toandeptrai16zz/UAV_FAMER/Tài Liệu/MC6C_Tam_Cu_SBUS.pdf

UAV F450 | Lưu thông số điều khiển MC6C | Trang 1

# THÔNG SỐ TÂM TAY ĐIỀU KHIỂN CŨ

Microzone MC6C + bộ thu MC7RE | Số liệu SBUS đã xác nhận trước khi chỉnh nhầm trên tay điều khiển.
ROLL · CH1 | PITCH · CH2 | YAW · CH4
952 | 1062 | 1099

Bảng giá trị SBUS đã ghi nhận

Kênh | Chức năng | Giá trị đã xác nhận
CH1 | Roll (trái/phải) | Trung tâm: 952
CH2 | Pitch (lên/xuống) | Trung tâm: 1062
CH3 | Throttle / Ga | Thấp nhất: 40 · Cao nhất: 1640
CH4 | Yaw (xoay) | Trung tâm: 1099
CH5 | ARM | OFF: 1000 · ON: 1800
CH6 | KILL | ON (ngắt motor): 1800 · OFF: 1000

Các hằng số đang lưu trong rc_input.h

RC_ROLL_CENTER = 952 RC_PITCH_CENTER = 1062 RC_YAW_CENTER = 1099 RC_STICK_DEADBAND = 20 RC_THR_MIN_RAW = 40 RC_THR_MAX_RAW = 1640

Lưu ý khi đối chiếu với tay điều khiển hiện tại

Các số trên là giá trị cũ đã đo, không nhất thiết là giá trị mới sau khi bấm nhầm hoặc reset tay. Không ghi đè bằng tâm hiện tại nếu chưa kiểm tra trim, MIX và hướng điều khiển. Với bài kiểm tra an toàn, tháo cánh và ngắt nguồn ESC trước khi chỉnh tay.

Nguồn: các log SBUS trước khi thay đổi cài đặt tay và tệp rc_input.h của dự án STM32G474RE.
