toandeptrai16zz/UAV_FAMER/PINOUT.png

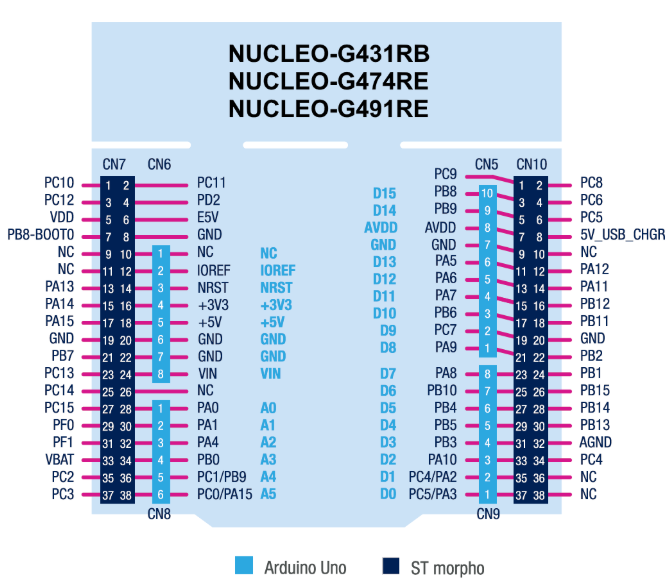
PINOUT.png
