toandeptrai16zz/UAV_FAMER/UAV_.ioc

Mcu.UserName=STM32G474RETx
PA13.Signal=SYS_JTMS-SWDIO
PA14.Signal=SYS_JTCK-SWCLK
PC1.Signal=LPUART1_TX
PC0.Signal=LPUART1_RX
PA7.Signal=S_TIM3_CH2
PA6.Signal=S_TIM3_CH1
PB0.Signal=S_TIM3_CH3
PB1.Signal=S_TIM3_CH4
PB12.GPIO_Label=IMU
PB12.Signal=GPIO_Output
PB13.Signal=SPI2_SCK
PB14.Signal=SPI2_MISO
PB15.Signal=SPI2_MOSI
PB7.Signal=USART1_RX
PB8-BOOT0.Signal=I2C1_SCL
PB9.Signal=I2C1_SDA
PC4.Signal=USART1_TX
PC10.Signal=USART3_TX
PC11.Signal=USART3_RX
