toandeptrai16zz/UAV_FAMER/Core/Src/main.c

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
/* Includes ------------------------------------------------------------------*/
#include "main.h"

/* USER CODE BEGIN Includes */
#include "uav_test.h"
/* USER CODE END Includes */


I2C_HandleTypeDef hi2c1;

UART_HandleTypeDef hlpuart1;
UART_HandleTypeDef huart1;
UART_HandleTypeDef huart3;

SPI_HandleTypeDef hspi2;

TIM_HandleTypeDef htim3;
DMA_HandleTypeDef hdma_tim3_up;

void SystemClock_Config(void);
static void MX_GPIO_Init(void);
static void MX_DMA_Init(void);
static void MX_TIM3_Init(void);
static void MX_USART1_UART_Init(void);
static void MX_USART3_UART_Init(void);
static void MX_LPUART1_UART_Init(void);
static void MX_SPI2_Init(void);
static void MX_I2C1_Init(void);
/**
  * @brief  The application entry point.
  * @retval int
  */
int main(void)
{

  /* MCU Configuration--------------------------------------------------------*/

  /* Reset of all peripherals, Initializes the Flash interface and the Systick. */
  HAL_Init();

  /* Configure the system clock */
  SystemClock_Config();

  /* Initialize all configured peripherals */
  MX_GPIO_Init();
  MX_DMA_Init();
  MX_TIM3_Init();
  MX_USART1_UART_Init();
  MX_USART3_UART_Init();
  MX_LPUART1_UART_Init();
  MX_SPI2_Init();
  MX_I2C1_Init();
  /* USER CODE BEGIN 2 */
  /* Initialize board indicators before enabling the TIM3 DShot output channels. */
  BSP_LED_Init(LED_GREEN);
  BSP_PB_Init(BUTTON_USER, BUTTON_MODE_EXTI);

  uav_test_init();
  /* USER CODE END 2 */

  /* Infinite loop */
  /* USER CODE BEGIN WHILE */
  while (1)
  {
    /* USER CODE END WHILE */

    /* USER CODE BEGIN 3 */
    /* Process SBUS, transmit DShot motor commands, and service IMU/barometer. */
    uav_test_loop();
  }
  /* USER CODE END 3 */
}

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
