toandeptrai16zz/UAV_FAMER/tests/test_flight.c

/* Execute the actual application state machine with mocked peripherals.
 * This is a software regression test, NOT an ESC/IMU/airframe simulator. */
#include <assert.h>
#include <stdlib.h>
#include "../Core/Src/uav_test.c"
static uint32_t tick;
static HAL_StatusTypeDef spi_result=HAL_OK;
static TIM_TypeDef timer;
UART_HandleTypeDef huart1,hlpuart1,huart3;
TIM_HandleTypeDef htim3={&timer};
SPI_HandleTypeDef hspi2;
DMA_HandleTypeDef hdma_tim3_up;
I2C_HandleTypeDef hi2c1;
<<<<<<< HEAD
/* UART bridge mocks: independent protocol module is tested separately. */
void UAVTelemetry_Reset(void) {}
bool UAVTelemetry_Send(UART_HandleTypeDef *u, const UAVTelemetrySample *s) {(void)u;(void)s;return true;}
void UAVTelemetry_OnTxComplete(UART_HandleTypeDef *u) {(void)u;}
bool UAVTelemetry_OnTxError(UART_HandleTypeDef *u) {(void)u;return false;}
uint32_t UAVTelemetry_GetDropped(void) {return 0;}
uint32_t UAVTelemetry_GetCompleted(void) {return 0;}
void UAVConfig_Init(UART_HandleTypeDef *u) {(void)u;}
void UAVConfig_OnRxComplete(UART_HandleTypeDef *u) {(void)u;}
void UAVConfig_OnTxComplete(UART_HandleTypeDef *u) {(void)u;}
void UAVConfig_OnError(UART_HandleTypeDef *u) {(void)u;}
void UAVConfig_Service(bool safe) {(void)safe;}
void UAVConfig_ServiceBoot(bool safe) {(void)safe;}
=======
>>>>>>> 7834c5139ab3419720ec722b83b541062d6e8a2e
uint32_t HAL_GetTick(void){return tick;}
void HAL_Delay(uint32_t x){tick+=x;}
void HAL_GPIO_WritePin(int p,int n,int v){(void)p;(void)n;(void)v;}
HAL_StatusTypeDef HAL_SPI_Transmit(SPI_HandleTypeDef*h,uint8_t*p,uint16_t n,uint32_t t){(void)h;(void)p;(void)n;(void)t;return spi_result;}
HAL_StatusTypeDef HAL_SPI_TransmitReceive(SPI_HandleTypeDef*h,uint8_t*a,uint8_t*b,uint16_t n,uint32_t t){(void)h;(void)a;(void)t;memset(b,0,n);if(n==14)b[4]=0x20;return spi_result;}
HAL_StatusTypeDef HAL_UART_Transmit_IT(UART_HandleTypeDef*h,uint8_t*p,uint16_t n){(void)h;(void)p;(void)n;return HAL_OK;}
HAL_StatusTypeDef HAL_UARTEx_ReceiveToIdle_IT(UART_HandleTypeDef*h,uint8_t*p,uint16_t n){(void)h;(void)p;(void)n;return HAL_OK;}
int HAL_DMA_GetState(DMA_HandleTypeDef*h){(void)h;return HAL_DMA_STATE_READY;}
HAL_StatusTypeDef HAL_DMA_Abort(DMA_HandleTypeDef*h){(void)h;return HAL_OK;}
HAL_StatusTypeDef HAL_DMA_Start_IT(DMA_HandleTypeDef*h,uint32_t a,uint32_t b,uint32_t n){(void)a;(void)b;assert(n==68);h->XferCpltCallback(h);return HAL_OK;}
HAL_StatusTypeDef HAL_TIM_PWM_Start(TIM_HandleTypeDef*h,uint32_t c){(void)h;(void)c;return HAL_OK;}
void Error_Handler(void){abort();}
bool DPS310_Init(DPS310_HandleTypeDef*d,I2C_HandleTypeDef*h,uint8_t a){(void)d;(void)h;(void)a;return false;}
bool DPS310_Update(DPS310_HandleTypeDef*d){(void)d;return false;}
bool DPS310_GetData(const DPS310_HandleTypeDef*d,DPS310_Data*b){(void)d;memset(b,0,sizeof(*b));return false;}
bool MT06_Init(MT06_HandleTypeDef*d,UART_HandleTypeDef*h){(void)d;(void)h;return false;}
void MT06_Update(MT06_HandleTypeDef*d){(void)d;}
void MT06_RxEventCallback(UART_HandleTypeDef*h,uint16_t n){(void)h;(void)n;}
void MT06_ErrorCallback(UART_HandleTypeDef*h){(void)h;}
bool MT06_GetData(const MT06_HandleTypeDef*d,MT06_Data*b){(void)d;memset(b,0,sizeof(*b));return false;}
static void setup(void){
 tick=10000;boot_ms=0;armed=false;spinning=false;arm_ready=false;arm_switch_prev=false;
 imu_ready=imu_calibrated=imu_control_valid=attitude_initialized=true;
 roll_angle=pitch_angle=0;gyro_x=gyro_y=gyro_z=0;
 gyro_bias_x_raw=gyro_bias_y_raw=gyro_bias_z_raw=0;
 imu_last_good_ms=tick;imu_sample_sequence=1;pid_last_sample_sequence=0;last_pid_ms=tick-1;
 link_prev=true;link_up_ms=tick-2000;low_tracking=true;low_since_ms=tick-1000;win_min=win_max=40;
 sbus_frames_ok=100;sbus_flags=0;sbus_last_valid_ms=tick;
 memset((void*)sbus_channels,0,sizeof(sbus_channels));
 sbus_channels[CH_ROLL]=RC_ROLL_CENTER;sbus_channels[CH_PITCH]=RC_PITCH_CENTER;sbus_channels[CH_YAW]=RC_YAW_CENTER;
 sbus_channels[CH_THR]=40;sbus_channels[CH_ARM]=1000;sbus_channels[CH_KILL]=1000;
 mc7re_guard_init(&mc7re_guard);mc7re_guard.latched=false;
 dshot_tx_done=1000;dshot_tx_errors=dshot_faults_observed=dshot_tx_done_at_fault=0;dshot_dma_error_pending=0;
 FlightPID_Reset(&flight_pid);FlightPIDSampleHold_Reset(&pid_sample_hold);
 outputs_force_zero();
}
static void step(void){tick++;imu_last_good_ms=tick;imu_sample_sequence++;sbus_last_valid_ms=tick;motor_step();}
static void arm_and_spin(void){setup();step();assert(arm_ready);sbus_channels[CH_ARM]=1800;step();assert(armed&&!spinning);sbus_channels[CH_THR]=800;step();assert(armed&&spinning);}
static void zero(void){for(int i=0;i<4;i++)assert(output_dshot[i]==0);}
static void test_arming(void){
 setup();sbus_channels[CH_ARM]=1800;step();assert(!armed);
 setup();step();sbus_channels[CH_ARM]=1800;roll_angle=20;step();assert(!armed);
 roll_angle=0;step();assert(!armed); /* regression: held ON used to arm here */
 sbus_channels[CH_ARM]=1000;step();sbus_channels[CH_ARM]=1800;step();assert(armed);
 arm_and_spin();sbus_channels[CH_KILL]=1800;step();assert(!armed);zero();
 sbus_channels[CH_KILL]=1000;step();assert(!armed);zero();
 puts("PASS ARM edge, failed attempt, normal spin, KILL, no automatic rearm");
}
static void test_faults(void){
 arm_and_spin();sbus_flags=SBUS_FLAG_FAILSAFE;step();assert(!armed&&mc7re_guard.latched);zero();
 arm_and_spin();tick+=101;imu_last_good_ms=tick;motor_step();assert(!armed);zero();
 arm_and_spin();sbus_channels[CH_ROLL]=sbus_channels[CH_PITCH]=sbus_channels[CH_YAW]=1000;sbus_channels[CH_THR]=40;step();assert(!armed);zero();
 arm_and_spin();dshot_dma_error_pending=1;dshot_tx_errors++;step();assert(!armed);zero();
 arm_and_spin();roll_angle=NAN;step();assert(!armed);zero();
 arm_and_spin();tick+=21;sbus_last_valid_ms=tick;motor_step();assert(!armed);zero();
 arm_and_spin();last_pid_ms=tick-30;step();assert(!armed);zero();
 puts("PASS SBUS failsafe/timeout/preset, DMA fault, invalid PID, PID time gap");
}
static void test_same_tick(void){
 arm_and_spin();last_pid_ms=tick;imu_sample_sequence++;motor_step();
 assert(armed&&spinning); /* zero dt keeps previous valid output */
 tick++;sbus_last_valid_ms=tick;last_attitude_update_ms=tick;
 uav_test_loop();assert(imu_control_valid&&armed&&spinning);
 puts("PASS same-ms sample timestamp retains control without false dropout");
}
static void test_imu_gap(void){
 arm_and_spin();last_attitude_update_ms=tick-30;tick++;sbus_last_valid_ms=tick;
 uav_test_loop();assert(!imu_control_valid&&!armed);zero();
 tick++;sbus_last_valid_ms=tick;uav_test_loop();assert(imu_control_valid&&!armed);zero();
 puts("PASS fresh SPI after >20 ms gap cannot mask stale attitude or rearm");
}
static void test_filter(void){
 accel_x=accel_y=0;accel_z=8192;gyro_x=gyro_y=gyro_z=0;gyro_bias_x_raw=gyro_bias_y_raw=gyro_bias_z_raw=0;
 attitude_initialized=true;sensor_roll_angle=10;sensor_pitch_angle=0;update_attitude(2);float v=sensor_roll_angle;
 sensor_roll_angle=10;update_attitude(1);update_attitude(1);assert(fabsf(v-sensor_roll_angle)<0.0001f);
 puts("PASS complementary decay equivalence at 1/2 ms for static gyro input");
}
static void test_mixer(void){
 float c[4],out[4],scale,offset;
 FlightPID_MixX(-60,0,0,c);assert(c[1]>c[0]&&c[3]>c[2]);
 FlightPID_MixX(0,60,0,c);assert(c[0]>c[2]&&c[1]>c[3]);
 for(int base=48;base<=2047;base+=7)for(int r=-200;r<=200;r+=40)for(int p=-200;p<=200;p+=40){
  FlightPID_MixX(r,p,170,c);assert(FlightPID_DesaturateMixer(base,c,48,2047,out,&scale,&offset));
  for(int i=0;i<4;i++){assert(out[i]>=48&&out[i]<=2047);for(int j=0;j<4;j++)assert(fabsf((out[i]-out[j])-(c[i]-c[j])*scale)<0.001f);}
 }
 c[0]=NAN;assert(!FlightPID_DesaturateMixer(100,c,48,2047,out,0,0));
 puts("PASS mixer directions, 34,606 saturation cases, invalid input");
}
static void test_protocol(void){
 for(unsigned value=0;value<=2047;value++){
  unsigned mapped=value?(value<48?48:value):0;
  unsigned packet=dshot_make_packet(value),payload=packet>>4;
  assert((payload>>1)==mapped && !(payload&1));
  assert(((packet>>12)^(packet>>8)^(packet>>4)^packet)%16==0);
 }
 assert(RC_ThrottleIsLow(40));assert(!RC_ThrottleIsLow(1640));
 assert(RC_StickNormalized(RC_ROLL_CENTER,RC_ROLL_CENTER)==0);
 uint8_t frame[25]={0};frame[0]=0x0f;
 uint16_t expected[16];
 for(unsigned ch=0;ch<16;ch++){
  expected[ch]=(uint16_t)((ch*131+40)&2047);
  for(unsigned b=0;b<11;b++)if(expected[ch]&(1u<<b))frame[1+(ch*11+b)/8]|=(uint8_t)(1u<<((ch*11+b)%8));
 }
 frame[23]=8;sbus_frame_pos=0;
 for(unsigned i=0;i<25;i++)sbus_feed_byte(frame[i]);
 for(unsigned ch=0;ch<16;ch++)assert(sbus_channels[ch]==expected[ch]);
 assert(sbus_flags==8);
 puts("PASS all DShot payloads/CRC, SBUS 16-channel decode, RC neutral/low throttle");
}
<<<<<<< HEAD
static void test_config_mode(void){
 setup();sbus_channels[CH_CONFIG]=1800;sbus_channels[CH_KILL]=1800;step();
 assert(uav_config_allowed && !armed && !spinning);
 sbus_channels[CH_KILL]=1000;step();assert(!uav_config_allowed);
 sbus_channels[CH_KILL]=1800;sbus_channels[CH_ARM]=1800;step();
 assert(!uav_config_allowed && !armed);
 sbus_channels[CH_ARM]=1000;step();assert(uav_config_allowed);
 sbus_channels[CH_CONFIG]=1000;step();assert(!uav_config_allowed);
 setup();step();sbus_channels[CH_ARM]=1800;step();assert(armed);
 sbus_channels[CH_CONFIG]=1800;step();assert(armed && !uav_config_allowed); /* no midflight disarm */
 puts("PASS physical CH8 config gate, ARM lock, no midflight CH8 disarm");
}
static void test_runtime_gains(void){
 FlightPIDGains baseline,g;
 FlightPID_DefaultGains(&baseline); FlightPID_GetGains(&g);
 assert(fabsf(g.rate_kp[0]-1.5f)<0.001f && fabsf(g.angle_kp-4.0f)<0.001f);
 g.rate_kp[0] = 1.2f; assert(FlightPID_SetGains(&g));
 g.rate_ki[1] = NAN; assert(!FlightPID_SetGains(&g));
 FlightPID_GetGains(&g); assert(fabsf(g.rate_kp[0]-1.2f)<0.001f);
 assert(FlightPID_SetGains(&baseline));
 puts("PASS runtime PID defaults, bounds, NAN rejection, atomic apply");
}
int main(void){
 test_runtime_gains(); test_config_mode();test_protocol();test_arming();test_faults();test_imu_gap();test_same_tick();test_filter();test_mixer();return 0;}
=======
int main(void){test_protocol();test_arming();test_faults();test_imu_gap();test_same_tick();test_filter();test_mixer();return 0;}
>>>>>>> 7834c5139ab3419720ec722b83b541062d6e8a2e
