toandeptrai16zz/UAV_FAMER/(commit log)

2026-10-28 Add IMU 6500, ổn định pwm
2026-10-28 Hiệu chỉnh gyro, tính PID
2026-10-29 mu: sửa lỗi hiệu chuẩn gyro, khởi tạo và ghi log • Chạy hiệu chuẩn gyro ngay sau khi khởi tạo IMU (trước đây là đoạn mã chết vì biến imu_ready ở trạng thái sai - false). • Thêm bước kiểm tra chuyển đ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
2026-10-29 Thêm file hướng dẫn và note tiến trình
2026-10-29 feat: Tích hợp đọc IMU MPU6500 qua SPI, bộ lọc góc và thuật toán PID
2026-10-29 Thay PWM sang Dshot viết bằng DMA Burst 4 kênh 300kHz
2026-10-29 Tối ưu PID, kết hợp IMU sau khi thay sang dshot
2026-10-31 Add Barometter && IMU, hiệu chỉnh để UAV giữ theo trục Z
2026-11-01 Add mô phỏng matlab simulink
2026-11-01 Add Rangerfinger MT6, cấu hình lại UAV.ioc, TÍnh toán lại PID
2026-11-02 Hiệu chỉnh yaw thực tế, góc thực tế và PID
2026-11-02 feat(uav): Hoàn thiện DShot300 và kiểm tra bộ điều khiển PID - Hoàn thiện giao tiếp DShot300 điều khiển 4 động cơ thông qua TIM3 và DMA. - Kiểm tra thành công hoạt động lần lượt của 4 động cơ. - Cập 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
2026-11-02 Bổ sung báo mất tín hiệu, hiệu chỉnh trục Z, chưa sẵn sàng cất cánh
2026-11-03 Có bay đấy nhưng PID như cứt
2026-11-04 Feat(UAV): Nâng cấp nạo dữ liệu không dây có bảo vệ, áp dụng đo dữ liệu từ xa, tinh chỉnh pid thực tế qua dashboard
2026-11-04 Chuyển đổi thư mục Tài Liệu sang Document
2026-11-04 Fix xung đột git do đổi nhầm tên:)))
2026-11-04 Đọc thông số từ xa Done, tích hợp nạp firm STM qua OTA thoogn qua ESP
2026-11-04 Add hướng dẫn và tài liệu phục vụ viết báo cáo
2026-11-04 feat: bổ sung Ground Station realtime, biểu đồ cảm biến và cập nhật tài liệu UAV
